maugsburger/blinkenkringel/README.md

blinkenkringel
==============

Just a simple and versatile pattern led strobe/flashing light.

Features
--------
Yes, even really small projects can have multiple features ;)
* Atmel ATtiny2313 powered
* multiple patterns (and still room for more)
* powerd by 2 AA cells (or one 18650)
* uses power-down mode, <0,2µA when switched off
* dynamic clocking for save power-on on battery-voltage, stepup-converter is enabled only when running

Video
-----

Breadboard Prototype:

blinkenkringel breadboard prototype (http://www.youtube.com/watch?v=y7mK5Jrenu8)
