maugsburger/blinkenkringel/blinkenkringel_sheet1.png

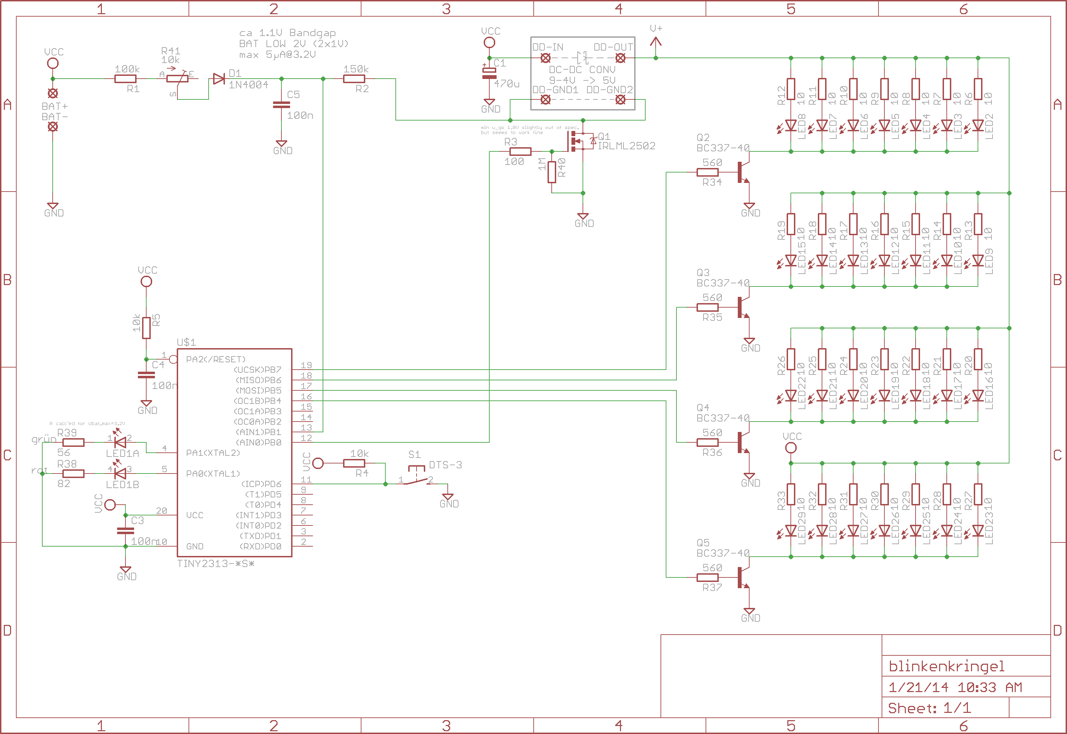
blinkenkringel_sheet1.png
