maugsburger/blinkenkringel/blinkenkringel.sch

## EAGLE design blinkenkringel.sch (2014-01-21)

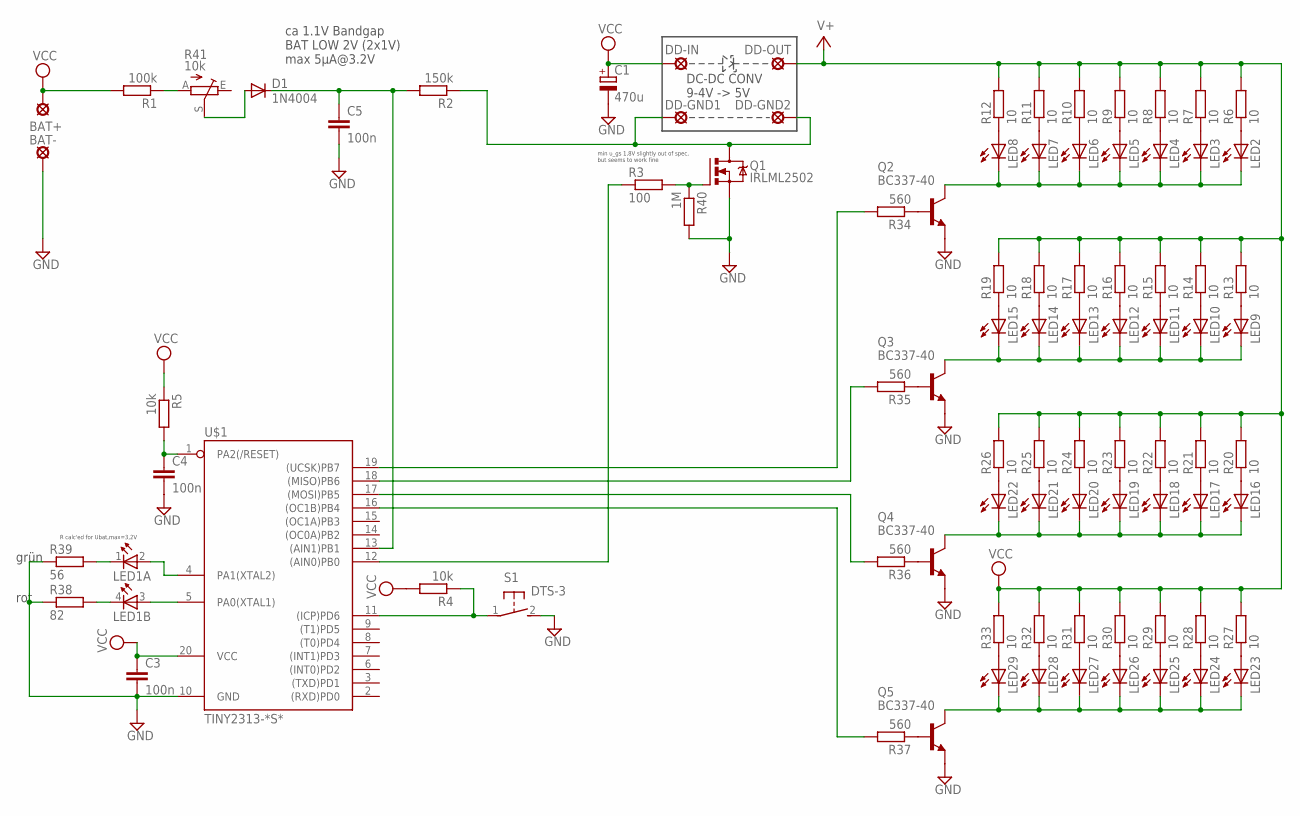
[picture p2: schematic blinkenkringel.sch]

Parts:
BAT+: MCS10B
BAT-: MCS10B
C1: 470u; E5-8,5
C3, C4, C5: 100n; C025-024X044
D1: 1N4004; DO41-10
DD-GND1, DD-GND2: MCS10B
DD-IN: MCS10B
DD-OUT: MCS10B
LED1: TOPLED-2--; P-LCC-4-2
LED2, LED3, LED4, LED5, LED6, LED7, LED8, LED9, LED10, LED11, LED12, LED13, LED14, LED15, LED16, LED17, LED18, LED19, LED20, LED21, LED22, LED23, LED24, LED25, LED26, LED27, LED28, LED29: LEDCHIPLED_0805; CHIPLED_0805
Q1: IRLML2502; MICRO3
Q2, Q3, Q4, Q5: BC337-40; TO92
R1: 100k; 0207/7
R2: 150k; 0207/7
R3: 100; 0207/7
R4, R5: 10k; 0207/7
R6, R7, R8, R9, R10, R11, R12, R13, R14, R15, R16, R17, R18, R19, R20, R21, R22, R23, R24, R25, R26, R27, R28, R29, R30, R31, R32, R33: 10; 0207/7
R34, R35, R36, R37: 560; 0207/7
R38: 82; 0207/7
R39: 56; 0207/7
R40: 1M; 0207/7
R41: 10k; CA9V
S1: DTS-3
U$1: TINY2313-*S*; SO20L$

Connections:
GND: BAT-.MP, C1.-, C3.2, C4.2, C5.2, Q1.2 (S), Q2.1 (E), Q3.1 (E), Q4.1 (E), Q5.1 (E), R38.1, R39.1, R40.2, S1.2, U$1.10 (GND)
unnamed: C4.1, R5.2, U$1.1 (PA2(/RESET))
unnamed: LED2.A, R6.1
unnamed: LED3.A, R7.1
unnamed: C5.1, D1.C, R2.2, U$1.13 ((AIN1)PB1)
unnamed: DD-GND1.MP, DD-GND2.MP, Q1.3 (D), R2.1
unnamed: Q1.1 (G), R3.2, R40.1
unnamed: LED4.A, R8.1
unnamed: LED5.A, R9.1
unnamed: LED6.A, R10.1
unnamed: LED7.A, R11.1
unnamed: LED8.A, R12.1
unnamed: Q2.2 (B), R34.1
unnamed: LED9.C, LED10.C, LED11.C, LED12.C, LED13.C, LED14.C, LED15.C, Q3.3 (C)
unnamed: LED9.A, R13.1
unnamed: LED10.A, R14.1
unnamed: LED11.A, R15.1
unnamed: LED12.A, R16.1
unnamed: LED13.A, R17.1
unnamed: LED14.A, R18.1
unnamed: LED15.A, R19.1
unnamed: Q3.2 (B), R35.1
unnamed: LED16.C, LED17.C, LED18.C, LED19.C, LED20.C, LED21.C, LED22.C, Q4.3 (C)
unnamed: LED16.A, R20.1
unnamed: LED17.A, R21.1
unnamed: LED18.A, R22.1
unnamed: LED19.A, R23.1
unnamed: LED20.A, R24.1
unnamed: LED21.A, R25.1
unnamed: LED22.A, R26.1
unnamed: Q4.2 (B), R36.1
unnamed: LED23.C, LED24.C, LED25.C, LED26.C, LED27.C, LED28.C, LED29.C, Q5.3 (C)
unnamed: LED23.A, R27.1
unnamed: LED24.A, R28.1
unnamed: LED25.A, R29.1
unnamed: LED26.A, R30.1
unnamed: LED27.A, R31.1
unnamed: LED28.A, R32.1
unnamed: LED29.A, R33.1
unnamed: Q5.2 (B), R37.1
unnamed: R36.2, U$1.17 ((MOSI)PB5)
unnamed: LED2.C, LED3.C, LED4.C, LED5.C, LED6.C, LED7.C, LED8.C, Q2.3 (C)
unnamed: R35.2, U$1.18 ((MISO)PB6)
unnamed: R34.2, U$1.19 ((UCSK)PB7)
unnamed: LED1.3 (A), U$1.5 (PA0(XTAL1))
unnamed: LED1.2 (A), U$1.4 (PA1(XTAL2))
unnamed: R4.1, S1.1, U$1.11 ((ICP)PD6)
unnamed: R3.1, U$1.12 ((AIN0)PB0)
unnamed: R37.2, U$1.16 ((OC1B)PB4)
unnamed: LED1.4 (C), R38.2
unnamed: LED1.1 (C), R39.2
unnamed: R1.1, R41.A
unnamed: D1.A, R41.S
V+: DD-OUT.MP, R6.2, R7.2, R8.2, R9.2, R10.2, R11.2, R12.2, R13.2, R14.2, R15.2, R16.2, R17.2, R18.2, R19.2, R20.2, R21.2, R22.2, R23.2, R24.2, R25.2, R26.2, R27.2, R28.2, R29.2, R30.2, R31.2, R32.2, R33.2
VCC: BAT+.MP, C1.+, C3.1, DD-IN.MP, R1.2, R4.2, R5.1, U$1.20 (VCC)

Notes on the sheet:
ca 1.1V Bandgap BAT LOW 2V (2x1V) max 5µA@3.2V
DC-DC CONV 9-4V -> 5V
min u_gs 1,8V slightly out of spec, but seems to work fine
R calc'ed for Ubat,max=3,2V
grün
rot
