maugsburger/blinkenkringel/measurements.md

Measurements
============

Battery
-------

| Mode | Empty Battery | Full Battery  |
| ---|:---:|:---:|
| all dual flash l4 | `2,04→0,76` | `3,12→1,40` |
| all on l4 | `1,00→0,60` | `2,00→1,36` |
| single rotate l1  | `1,88→1,68` | `3,04→2,44` |
