maugsburger/blinkenkringel/(commit log)

2014-01-11 dumb tri-state pwm
2014-01-12 four intensity level pwm routine finished
2014-01-14 unstructured mass-commit
    everything but powermanagement (seems to) work(s)
2014-01-15 pwm test pattern added
2014-01-15 start power management
2014-01-15 enable idle sleep while waiting for timer interrupt
2014-01-15 disable timer in pwrdown
2014-01-15 poweroff-sleep and re-awake with full reset
    [main.c, sleep.c]
2014-01-15 rename status leds to tell apart from signal leds
2014-01-15 implement powerdown
    switch off dcdc converter
    change clock divider while running at battery power
2014-01-15 led mode tuning, wait for released key before sleeping
2014-01-15 add schematics, WARNING: not matching current code!
    [blinkenkringel.sch]
2014-01-15 forgotten connection led-resistor added
    [blinkenkringel.sch]
2014-01-16 supply voltage monitoring functional
2014-01-16 changed voltage divider
    [blinkenkringel.sch]
2014-01-16 max power drain mode for bat testing
2014-01-16 capacitor at reset line for BOD detection/reset
    [blinkenkringel.sch]
2014-01-16 drawn internal schottky diode in stepup converter to clarify functioning
    [blinkenkringel.sch]
2014-01-16 battery measurements
2014-01-16 changed comparator in for better noise filtering
    [blinkenkringel.sch]
2014-01-17 move power boost on/off to function in sleep.c
2014-01-18 free successive pins, uc directly on bats
    [blinkenkringel.sch]
2014-01-19 mass commit
    too many changes, things I can remember:
    - detect bod reset and prevent normal operation afterwards, instead
    just blink for notification
    - battery level detection, kicks in at about 2.2V on batteries
    (measured using eneloops and all leds on full power: total runtime
    ~3h, warning starts ~1/2 hour before shutdown)
    - helper functions power_led_(on|off|toggle)
    [key.h, led.c, led.h, main.c, patterns.h, sleep.c]
2014-01-20 matching schematics and reality: pot for low bat voltage
    [blinkenkringel.sch]
2014-01-20 misplaced capacitor
    [blinkenkringel.sch]
2014-01-20 adjusted ports etc to match built up layout (and schematics)
2014-01-21 got the cap connected wrong
    [blinkenkringel.sch]
2015-01-23 lec.d: less pwm artefacts
2015-02-02 use correct pcint vector and register field name
    [sleep.c]
2015-02-02 correct timer for 4MHz
    [key.c]
2015-02-02 dont wait too long after power up
    [main.c]
